SlimeVR/SlimeVR-Morphocharger/pcb/MorphoDock.kicad_pcb

## KiCad design pcb/MorphoDock.kicad_pcb (2026-10-28)

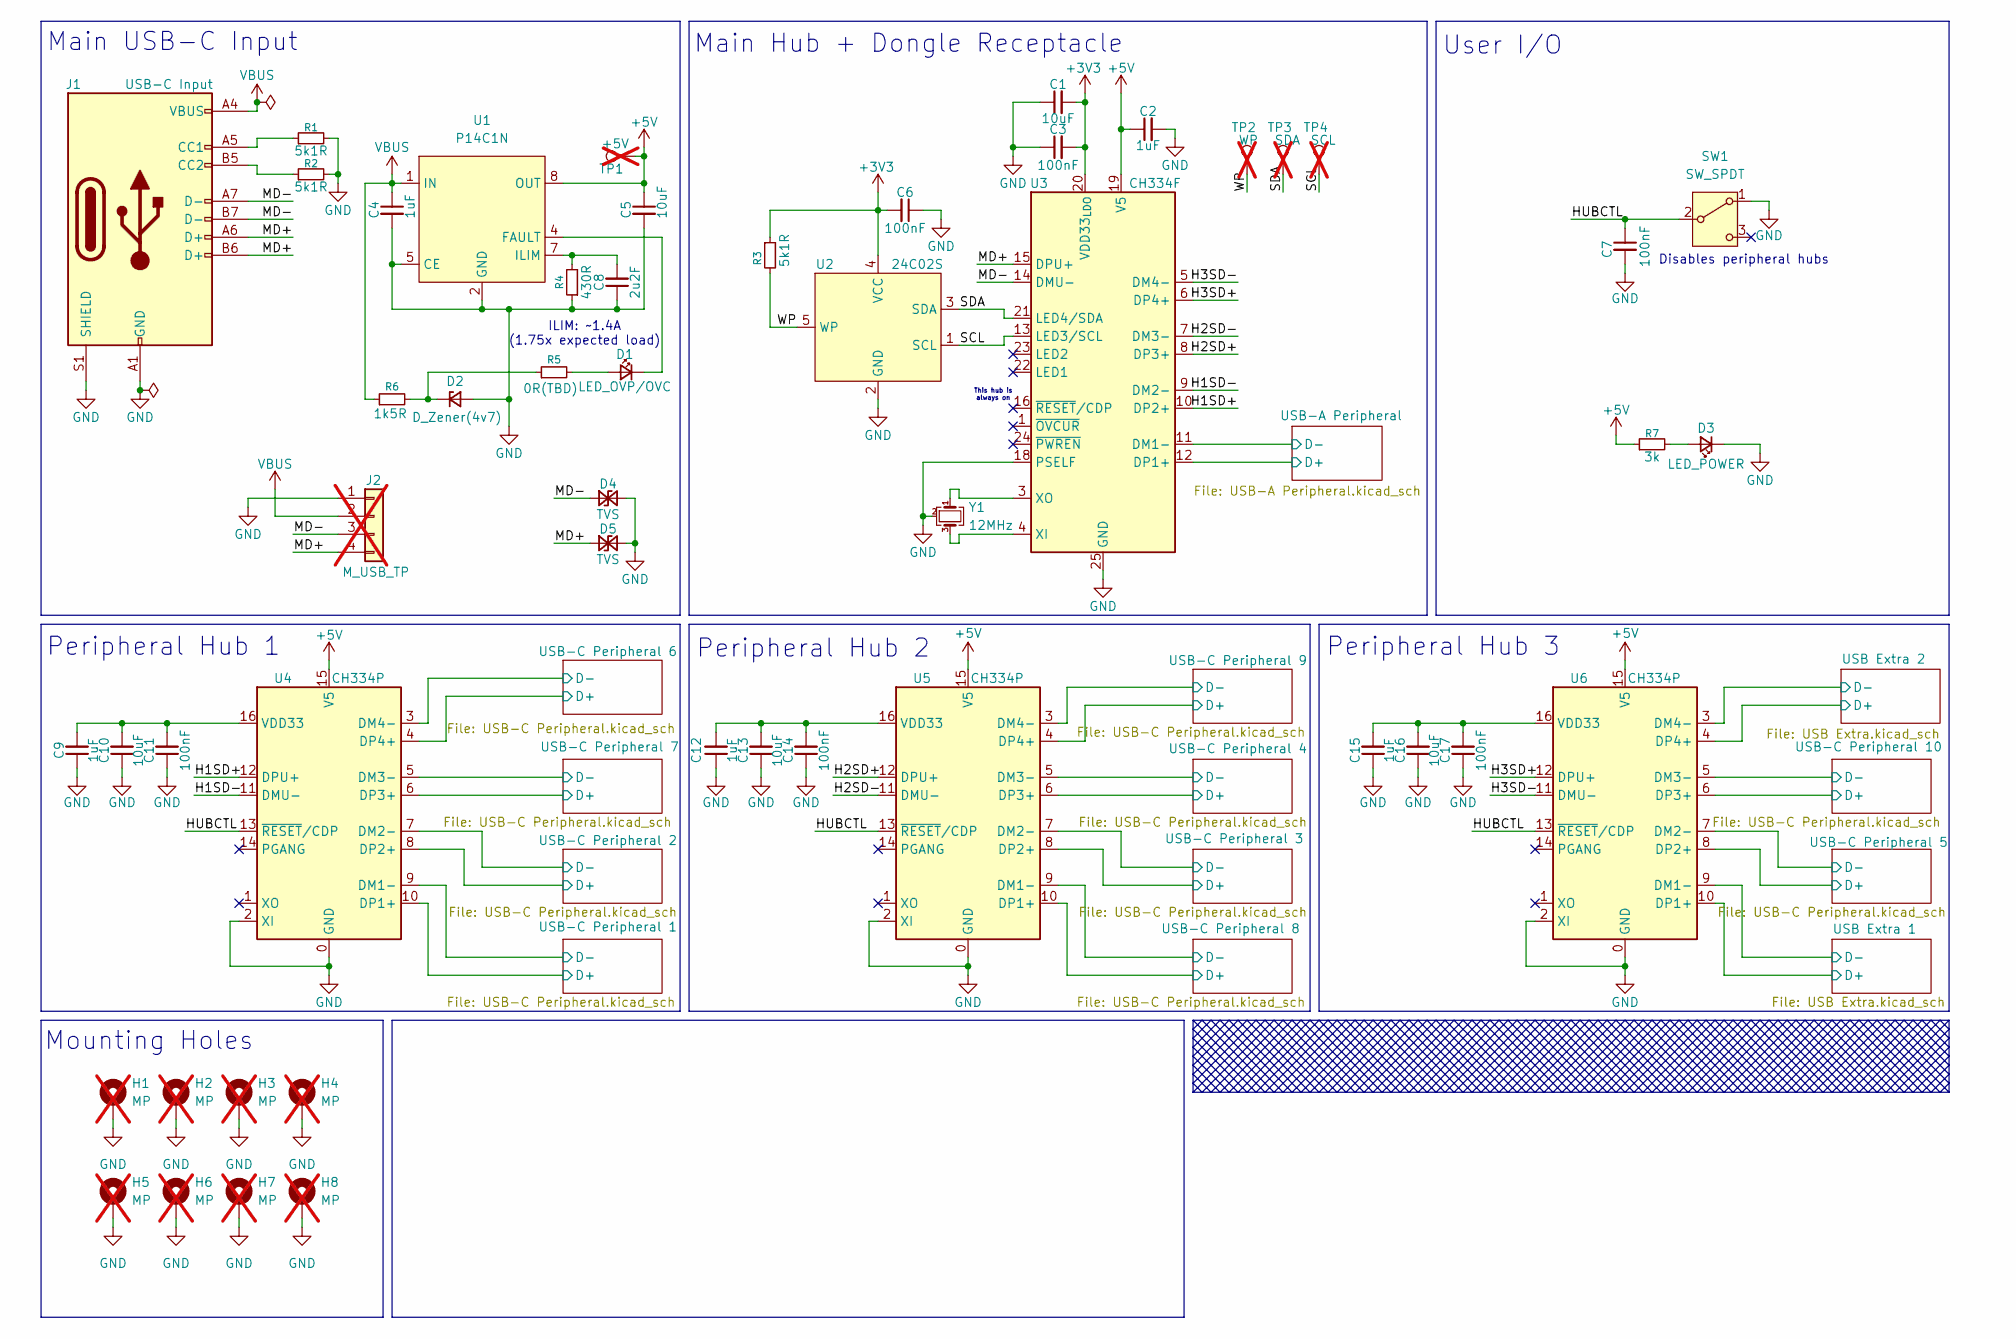
[picture p2: schematic MorphoDock.kicad_sch]

Parts:
C1, C5, C10, C13, C16: 10uF; C_0603; MPN C19702
C2, C4, C9, C12, C15: 1uF; C_0603; MPN C5199872
C3, C6, C7, C11, C14, C17: 100nF; C_0603; MPN C1591
C8: 2u2F; C_0603; MPN C86018
D1: LED_OVP/OVC; LED_SMD_1.7x0.6_H; MPN C125114
D2: D_Zener(4v7); D_SOD-123; MPN C173408
D3: LED_POWER; LED_SMD_1.7x0.6_H; MPN C125113
D4, D5: TVS; D_TVS_0603; MPN C10677
H1, H2, H3, H4, H5, H6, H7, H8: MP; MPN N/A; not fitted
J1: USB-C Input; USB-C_SMD_F_H; MPN C2765186
J2: M_USB_TP; TP_THT_2x2_2.54mm; MPN N/A; not fitted
R1, R2, R3: 5k1R; R_0603; MPN C23186
R4: 430R; R_0603; MPN C23170
R5: 0R(TBD); R_0603; MPN C21189
R6: 1k5R; R_1210; MPN C422399
R7: 3k; R_0603; MPN C4211
SW1: SW_SPDT; SW_THT_SK12D07VG4; MPN C393937
TP1: +5V; TP_THT_1x1_2.54mm; MPN N/A; not fitted
TP2: WP; TP_THT_1x1_2.54mm; MPN N/A; not fitted
TP3: SDA; TP_THT_1x1_2.54mm; MPN N/A; not fitted
TP4: SCL; TP_THT_1x1_2.54mm; MPN N/A; not fitted
U1: P14C1N; DFN-8_2x2_P0.5_EP0.8x1.6; MPN C1021678
U2: 24C02S; SOT-23-5; MPN C18723540
U3: CH334F; QFN-24-4x4-P0.5-EP2.7; MPN C5187527
U4, U5, U6: CH334P; QFN-16-3x3; MPN C5373042
Y1: 12MHz; XTAL_3225_4P; MPN C9002

Connections:
+3V3: C1.2, C3.2, C6.2, R3.1, U2.4 (VCC), U3.20 (VDD33_{LDO})
+5V: C2.1, C5.1, R7.1, TP1.1 (1_1), U1.8 (OUT), U3.19 (V5), U4.15 (V5), U5.15 (V5), U6.15 (V5); also elsewhere on the board
/H1SD+: U3.10 (DP2+), U4.12 (DPU+)
/H1SD-: U3.9 (DM2-), U4.11 (DMU-)
/H2SD+: U3.8 (DP3+), U5.12 (DPU+)
/H2SD-: U3.7 (DM3-), U5.11 (DMU-)
/H3SD+: U3.6 (DP4+), U6.12 (DPU+)
/H3SD-: U3.5 (DM4-), U6.11 (DMU-)
/HUBCTL: C7.1, SW1.2 (B), U4.13 (~RESET/CDP), U5.13 (~RESET/CDP), U6.13 (~RESET/CDP)
/MD+: D5.1 (A1), J1.A6 (D+), J1.B6 (D+), J2.4, U3.15 (DPU+)
/MD-: D4.1 (A1), J1.A7 (D-), J1.B7 (D-), J2.3, U3.14 (DMU-)
/SCL: TP4.1 (1_1), U2.1 (SCL), U3.13 (LED3/SCL)
/SDA: TP3.1 (1_1), U2.3 (SDA), U3.21 (LED4/SDA)
/USB Extra 1/D+: U6.10 (DP1+); also elsewhere on the board
/USB Extra 1/D-: U6.9 (DM1-); also elsewhere on the board
/USB Extra 2/D+: U6.4 (DP4+); also elsewhere on the board
/USB Extra 2/D-: U6.3 (DM4-); also elsewhere on the board
/USB-A Peripheral/D+: U3.12 (DP1+); also elsewhere on the board
/USB-A Peripheral/D-: U3.11 (DM1-); also elsewhere on the board
/USB-C Peripheral 1/D+: U4.10 (DP1+); also elsewhere on the board
/USB-C Peripheral 1/D-: U4.9 (DM1-); also elsewhere on the board
/USB-C Peripheral 2/D+: U4.8 (DP2+); also elsewhere on the board
/USB-C Peripheral 2/D-: U4.7 (DM2-); also elsewhere on the board
/USB-C Peripheral 3/D+: U5.8 (DP2+); also elsewhere on the board
/USB-C Peripheral 3/D-: U5.7 (DM2-); also elsewhere on the board
/USB-C Peripheral 4/D+: U5.6 (DP3+); also elsewhere on the board
/USB-C Peripheral 4/D-: U5.5 (DM3-); also elsewhere on the board
/USB-C Peripheral 5/D+: U6.8 (DP2+); also elsewhere on the board
/USB-C Peripheral 5/D-: U6.7 (DM2-); also elsewhere on the board
/USB-C Peripheral 6/D+: U4.4 (DP4+); also elsewhere on the board
/USB-C Peripheral 6/D-: U4.3 (DM4-); also elsewhere on the board
/USB-C Peripheral 7/D+: U4.6 (DP3+); also elsewhere on the board
/USB-C Peripheral 7/D-: U4.5 (DM3-); also elsewhere on the board
/USB-C Peripheral 8/D+: U5.10 (DP1+); also elsewhere on the board
/USB-C Peripheral 8/D-: U5.9 (DM1-); also elsewhere on the board
/USB-C Peripheral 9/D+: U5.4 (DP4+); also elsewhere on the board
/USB-C Peripheral 9/D-: U5.3 (DM4-); also elsewhere on the board
/USB-C Peripheral 10/D+: U6.6 (DP3+); also elsewhere on the board
/USB-C Peripheral 10/D-: U6.5 (DM3-); also elsewhere on the board
/WP: R3.2, TP2.1 (1_1), U2.5 (WP)
GND: C1.1, C2.2, C3.1, C4.2, C5.2, C6.1, C7.2, C8.1, C9.1, C10.1, C11.1, C12.1, C13.1, C14.1, C15.1, C16.1, C17.1, D2.2 (A), D3.1 (K), D4.2 (A2), D5.2 (A2), H1.1 (1_1), H2.1 (1_1), H3.1 (1_1), H4.1 (1_1), H5.1 (1_1), H6.1 (1_1), H7.1 (1_1), H8.1 (1_1), J1.A1 (GND), J1.A12 (GND), J1.B1 (GND), J1.B12 (GND), J1.S1 (SHIELD), J2.1, R1.2, R2.2, R4.1, SW1.1 (A), U1.2 (GND), U1.5 (CE), U2.2 (GND), U3.18 (PSELF), U3.25 (GND), U4.0 (GND), U4.2 (XI), U5.0 (GND), U5.2 (XI), U6.0 (GND), U6.2 (XI), Y1.2 (G), Y1.4 (G); also elsewhere on the board
unnamed: D1.2 (A), R5.2
unnamed: D1.1 (K), U1.4 (FAULT)
unnamed: D2.1 (K), R5.1, R6.2
unnamed: D3.2 (A), R7.2
unnamed: J1.A5 (CC1), R1.1
unnamed: J1.B5 (CC2), R2.1
unnamed: C8.2, R4.2, U1.7 (ILIM)
unnamed: U3.4 (XI), Y1.3
unnamed: U3.3 (XO), Y1.1
unnamed: C9.2, C10.2, C11.2, U4.16 (VDD33)
unnamed: C12.2, C13.2, C14.2, U5.16 (VDD33)
unnamed: C15.2, C16.2, C17.2, U6.16 (VDD33)
VBUS: C4.1, J1.A4 (VBUS), J1.A9 (VBUS), J1.B4 (VBUS), J1.B9 (VBUS), J2.2, R6.1, U1.1 (IN)

Notes on the sheet:
Disables peripheral hubs
Peripheral Hub 2
ILIM: ~1.4A (1.75x expected load)
User I/O
Peripheral Hub 3
This hub is always on
Peripheral Hub 1
Mounting Holes
Main Hub + Dongle Receptacle
Main USB-C Input

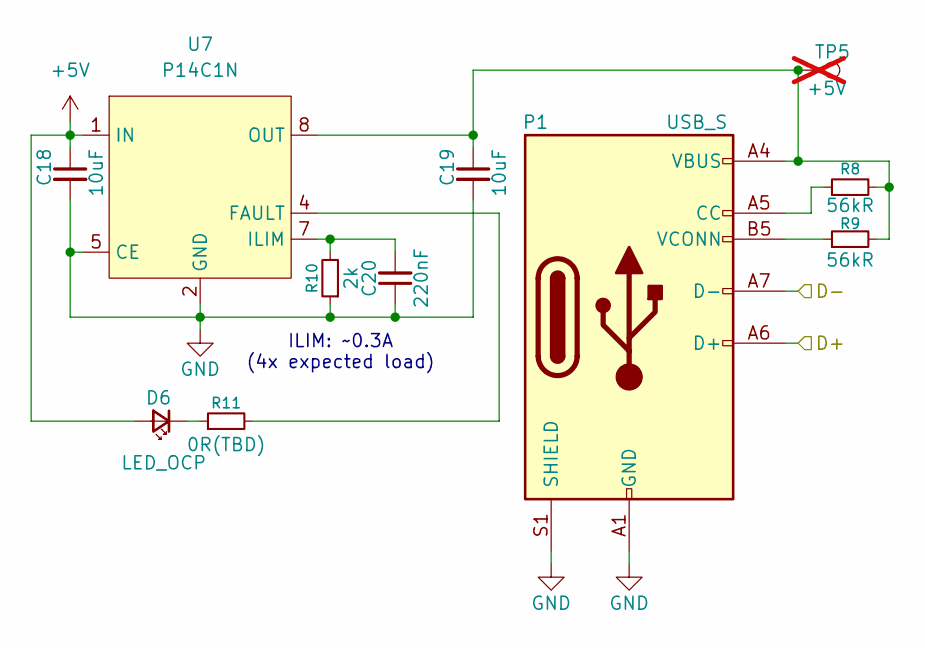
[picture p3: schematic USB-C Peripheral.kicad_sch]

Parts:
C18, C19: 10uF; C_0603; MPN C19702
C20: 220nF; C_0603; MPN C97857
D6: LED_OCP; LED_0603; MPN C125099
P1: USB_S; USB-C_H_M_V; MPN C6332285
R8, R9: 56kR; R_0603; MPN C23206
R10: 2k; R_0603; MPN C22975
R11: 0R(TBD); R_0603; MPN C21189
TP5: +5V; TP_THT_1x1_2.54mm; MPN N/A; not fitted
U7: P14C1N; DFN-8_2x2_P0.5_EP0.8x1.6; MPN C1021678

Connections:
+5V: C18.1, D6.2 (A), U7.1 (IN); also elsewhere on the board
/USB-C Peripheral 1/D+: P1.A6 (D+); also elsewhere on the board
/USB-C Peripheral 1/D-: P1.A7 (D-); also elsewhere on the board
GND: C18.2, C19.2, C20.1, P1.A1 (GND), P1.A12 (GND), P1.B1 (GND), P1.B12 (GND), P1.S1 (SHIELD), R10.1, U7.2 (GND), U7.5 (CE); also elsewhere on the board
unnamed: D6.1 (K), R11.1
unnamed: P1.A5 (CC), R8.1
unnamed: P1.B5 (VCONN), R9.1
unnamed: R11.2, U7.4 (FAULT)
unnamed: C20.2, R10.2, U7.7 (ILIM)
unnamed: C19.1, P1.A4 (VBUS), P1.A9 (VBUS), P1.B4 (VBUS), P1.B9 (VBUS), R8.2, R9.2, TP5.1 (1_1), U7.8 (OUT)

Parts of its further copies:
C21, C22, C24, C25, C27, C28, C30, C31, C33, C34, C36, C37, C39, C40, C42, C43, C45, C46: 10uF; C_0603; MPN C19702
C23, C26, C29, C32, C35, C38, C41, C44, C47: 220nF; C_0603; MPN C97857
D7, D8, D9, D10, D11, D12, D13, D14, D15: LED_OCP; LED_0603; MPN C125099
P2, P3, P4, P5, P6, P7, P8, P9, P10: USB_S; USB-C_H_M_V; MPN C6332285
R12, R13, R16, R17, R20, R21, R24, R25, R28, R29, R32, R33, R36, R37, R40, R41, R44, R45: 56kR; R_0603; MPN C23206
R14, R18, R22, R26, R30, R34, R38, R42, R46: 2k; R_0603; MPN C22975
R15, R19, R23, R27, R31, R35, R39, R43, R47: 0R(TBD); R_0603; MPN C21189
TP6, TP7, TP8, TP9, TP10, TP11, TP12, TP13, TP14: +5V; TP_THT_1x1_2.54mm; MPN N/A; not fitted
U8, U9, U10, U11, U12, U13, U14, U15, U16: P14C1N; DFN-8_2x2_P0.5_EP0.8x1.6; MPN C1021678

Connections of its further copies:
+5V: C21.1, C24.1, C27.1, C30.1, C33.1, C36.1, C39.1, C42.1, C45.1, D7.2 (A), D8.2 (A), D9.2 (A), D10.2 (A), D11.2 (A), D12.2 (A), D13.2 (A), D14.2 (A), D15.2 (A), U8.1 (IN), U9.1 (IN), U10.1 (IN), U11.1 (IN), U12.1 (IN), U13.1 (IN), U14.1 (IN), U15.1 (IN), U16.1 (IN); also elsewhere on the board
/USB-C Peripheral 2/D+: P2.A6 (D+); also elsewhere on the board
/USB-C Peripheral 2/D-: P2.A7 (D-); also elsewhere on the board
/USB-C Peripheral 3/D+: P3.A6 (D+); also elsewhere on the board
/USB-C Peripheral 3/D-: P3.A7 (D-); also elsewhere on the board
/USB-C Peripheral 4/D+: P4.A6 (D+); also elsewhere on the board
/USB-C Peripheral 4/D-: P4.A7 (D-); also elsewhere on the board
/USB-C Peripheral 5/D+: P5.A6 (D+); also elsewhere on the board
/USB-C Peripheral 5/D-: P5.A7 (D-); also elsewhere on the board
/USB-C Peripheral 6/D+: P6.A6 (D+); also elsewhere on the board
/USB-C Peripheral 6/D-: P6.A7 (D-); also elsewhere on the board
/USB-C Peripheral 7/D+: P7.A6 (D+); also elsewhere on the board
/USB-C Peripheral 7/D-: P7.A7 (D-); also elsewhere on the board
/USB-C Peripheral 8/D+: P8.A6 (D+); also elsewhere on the board
/USB-C Peripheral 8/D-: P8.A7 (D-); also elsewhere on the board
/USB-C Peripheral 9/D+: P9.A6 (D+); also elsewhere on the board
/USB-C Peripheral 9/D-: P9.A7 (D-); also elsewhere on the board
/USB-C Peripheral 10/D+: P10.A6 (D+); also elsewhere on the board
/USB-C Peripheral 10/D-: P10.A7 (D-); also elsewhere on the board
GND: C21.2, C22.2, C23.1, C24.2, C25.2, C26.1, C27.2, C28.2, C29.1, C30.2, C31.2, C32.1, C33.2, C34.2, C35.1, C36.2, C37.2, C38.1, C39.2, C40.2, C41.1, C42.2, C43.2, C44.1, C45.2, C46.2, C47.1, P2.A1 (GND), P2.A12 (GND), P2.B1 (GND), P2.B12 (GND), P2.S1 (SHIELD), P3.A1 (GND), P3.A12 (GND), P3.B1 (GND), P3.B12 (GND), P3.S1 (SHIELD), P4.A1 (GND), P4.A12 (GND), P4.B1 (GND), P4.B12 (GND), P4.S1 (SHIELD), P5.A1 (GND), P5.A12 (GND), P5.B1 (GND), P5.B12 (GND), P5.S1 (SHIELD), P6.A1 (GND), P6.A12 (GND), P6.B1 (GND), P6.B12 (GND), P6.S1 (SHIELD), P7.A1 (GND), P7.A12 (GND), P7.B1 (GND), P7.B12 (GND), P7.S1 (SHIELD), P8.A1 (GND), P8.A12 (GND), P8.B1 (GND), P8.B12 (GND), P8.S1 (SHIELD), P9.A1 (GND), P9.A12 (GND), P9.B1 (GND), P9.B12 (GND), P9.S1 (SHIELD), P10.A1 (GND), P10.A12 (GND), P10.B1 (GND), P10.B12 (GND), P10.S1 (SHIELD), R14.1, R18.1, R22.1, R26.1, R30.1, R34.1, R38.1, R42.1, R46.1, U8.2 (GND), U8.5 (CE), U9.2 (GND), U9.5 (CE), U10.2 (GND), U10.5 (CE), U11.2 (GND), U11.5 (CE), U12.2 (GND), U12.5 (CE), U13.2 (GND), U13.5 (CE), U14.2 (GND), U14.5 (CE), U15.2 (GND), U15.5 (CE), U16.2 (GND), U16.5 (CE); also elsewhere on the board
unnamed: D7.1 (K), R15.1
unnamed: D8.1 (K), R19.1
unnamed: D9.1 (K), R23.1
unnamed: D10.1 (K), R27.1
unnamed: D11.1 (K), R31.1
unnamed: D12.1 (K), R35.1
unnamed: D13.1 (K), R39.1
unnamed: D14.1 (K), R43.1
unnamed: D15.1 (K), R47.1
unnamed: P2.A5 (CC), R12.1
unnamed: P2.B5 (VCONN), R13.1
unnamed: P3.A5 (CC), R16.1
unnamed: P3.B5 (VCONN), R17.1
unnamed: P4.A5 (CC), R20.1
unnamed: P4.B5 (VCONN), R21.1
unnamed: P5.A5 (CC), R24.1
unnamed: P5.B5 (VCONN), R25.1
unnamed: P6.A5 (CC), R28.1
unnamed: P6.B5 (VCONN), R29.1
unnamed: P7.A5 (CC), R32.1
unnamed: P7.B5 (VCONN), R33.1
unnamed: P8.A5 (CC), R36.1
unnamed: P8.B5 (VCONN), R37.1
unnamed: P9.A5 (CC), R40.1
unnamed: P9.B5 (VCONN), R41.1
unnamed: P10.A5 (CC), R44.1
unnamed: P10.B5 (VCONN), R45.1
unnamed: R15.2, U8.4 (FAULT)
unnamed: C23.2, R14.2, U8.7 (ILIM)
unnamed: C22.1, P2.A4 (VBUS), P2.A9 (VBUS), P2.B4 (VBUS), P2.B9 (VBUS), R12.2, R13.2, TP6.1 (1_1), U8.8 (OUT)
unnamed: R19.2, U9.4 (FAULT)
unnamed: C26.2, R18.2, U9.7 (ILIM)
unnamed: C25.1, P3.A4 (VBUS), P3.A9 (VBUS), P3.B4 (VBUS), P3.B9 (VBUS), R16.2, R17.2, TP7.1 (1_1), U9.8 (OUT)
unnamed: R23.2, U10.4 (FAULT)
unnamed: C29.2, R22.2, U10.7 (ILIM)
unnamed: C28.1, P4.A4 (VBUS), P4.A9 (VBUS), P4.B4 (VBUS), P4.B9 (VBUS), R20.2, R21.2, TP8.1 (1_1), U10.8 (OUT)
unnamed: R27.2, U11.4 (FAULT)
unnamed: C32.2, R26.2, U11.7 (ILIM)
unnamed: C31.1, P5.A4 (VBUS), P5.A9 (VBUS), P5.B4 (VBUS), P5.B9 (VBUS), R24.2, R25.2, TP9.1 (1_1), U11.8 (OUT)
unnamed: R31.2, U12.4 (FAULT)
unnamed: C35.2, R30.2, U12.7 (ILIM)
unnamed: C34.1, P6.A4 (VBUS), P6.A9 (VBUS), P6.B4 (VBUS), P6.B9 (VBUS), R28.2, R29.2, TP10.1 (1_1), U12.8 (OUT)
unnamed: R35.2, U13.4 (FAULT)
unnamed: C38.2, R34.2, U13.7 (ILIM)
unnamed: C37.1, P7.A4 (VBUS), P7.A9 (VBUS), P7.B4 (VBUS), P7.B9 (VBUS), R32.2, R33.2, TP11.1 (1_1), U13.8 (OUT)
unnamed: R39.2, U14.4 (FAULT)
unnamed: C41.2, R38.2, U14.7 (ILIM)
unnamed: C40.1, P8.A4 (VBUS), P8.A9 (VBUS), P8.B4 (VBUS), P8.B9 (VBUS), R36.2, R37.2, TP12.1 (1_1), U14.8 (OUT)
unnamed: R43.2, U15.4 (FAULT)
unnamed: C44.2, R42.2, U15.7 (ILIM)
unnamed: C43.1, P9.A4 (VBUS), P9.A9 (VBUS), P9.B4 (VBUS), P9.B9 (VBUS), R40.2, R41.2, TP13.1 (1_1), U15.8 (OUT)
unnamed: R47.2, U16.4 (FAULT)
unnamed: C47.2, R46.2, U16.7 (ILIM)
unnamed: C46.1, P10.A4 (VBUS), P10.A9 (VBUS), P10.B4 (VBUS), P10.B9 (VBUS), R44.2, R45.2, TP14.1 (1_1), U16.8 (OUT)

Notes on the sheet:
ILIM: ~0.3A (4x expected load)

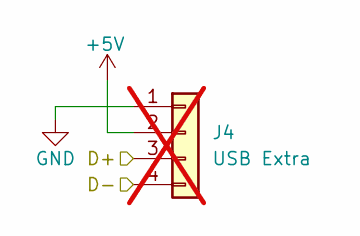
[picture p4: schematic USB Extra.kicad_sch]

Parts:
J4: USB Extra; TP_THT_2x2_2.54mm; not fitted

Connections:
+5V: J4.2; also elsewhere on the board
/USB Extra 1/D+: J4.3; also elsewhere on the board
/USB Extra 1/D-: J4.4; also elsewhere on the board
GND: J4.1; also elsewhere on the board

Parts of its further copies:
J5: USB Extra; TP_THT_2x2_2.54mm; not fitted

Connections of its further copies:
+5V: J5.2; also elsewhere on the board
/USB Extra 2/D+: J5.3; also elsewhere on the board
/USB Extra 2/D-: J5.4; also elsewhere on the board
GND: J5.1; also elsewhere on the board

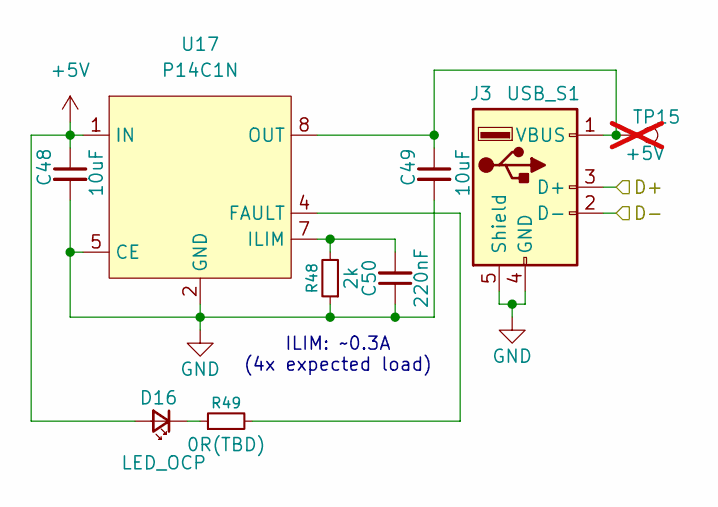
[picture p5: schematic USB-A Peripheral.kicad_sch]

Parts:
C48, C49: 10uF; C_0603; MPN C19702
C50: 220nF; C_0603; MPN C97857
D16: LED_OCP; LED_0603; MPN C125099
J3: USB_S1; USB-A_THT_F_V; MPN C42543
R48: 2k; R_0603; MPN C22975
R49: 0R(TBD); R_0603; MPN C21189
TP15: +5V; TP_THT_1x1_2.54mm; MPN N/A; not fitted
U17: P14C1N; DFN-8_2x2_P0.5_EP0.8x1.6; MPN C1021678

Connections:
+5V: C48.1, D16.2 (A), U17.1 (IN); also elsewhere on the board
/USB-A Peripheral/D+: J3.3 (D+); also elsewhere on the board
/USB-A Peripheral/D-: J3.2 (D-); also elsewhere on the board
GND: C48.2, C49.2, C50.1, J3.4 (GND), J3.5 (Shield), R48.1, U17.2 (GND), U17.5 (CE); also elsewhere on the board
unnamed: D16.1 (K), R49.1
unnamed: C49.1, J3.1 (VBUS), TP15.1 (1_1), U17.8 (OUT)
unnamed: R49.2, U17.4 (FAULT)
unnamed: C50.2, R48.2, U17.7 (ILIM)

Notes on the sheet:
ILIM: ~0.3A (4x expected load)

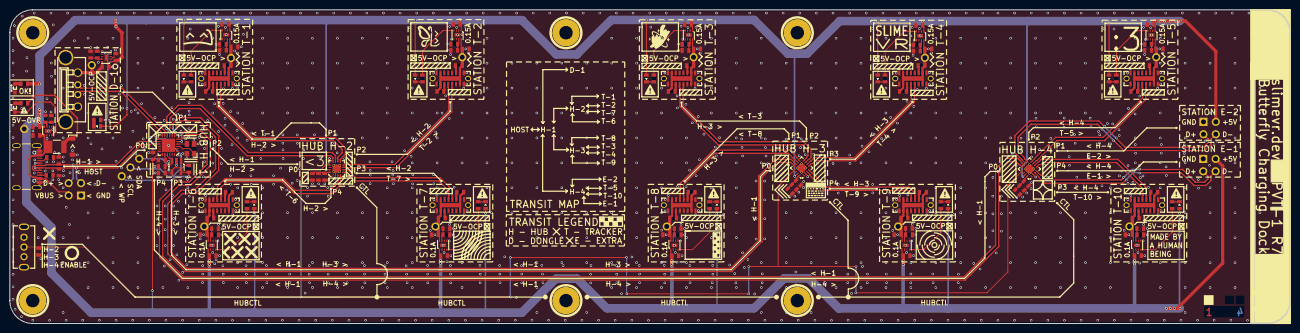
[picture p6: board MorphoDock.kicad_pcb from above]

Board: 4 copper layers, 262.9 x 64.4 mm, 172 parts (0 on the bottom side), 118 nets.
